keyraphi/esp8266_infrasound/(commit log)

2024-06-28 Started on wifi setting page. Submit button is not working yet
2024-07-03 Use arduino ide to code the esp8266
2024-07-07 Fixed missing minimum buffer size
    [infrasound_esp.ino.cpp]
2024-07-14 Bug fix ... data file was not opened.
    [arduino_infrasound_sensor.ino.cpp, esp8266_infrasound_webserver.ino.cpp]
2024-07-14 Send initial sensor data request asynchronously
2024-09-22 Use a D1 mini for the sensor
2024-09-25 Keep track of measurement index.
2024-10-10 Integrated Spectrogram to actual measurements and simple bug fixes
    [esp8266_infrasound_webserver.ino.cpp]
2024-10-20 Switch ui elements on and off
2024-10-22 Replaced wifi setup with setup via usb
    [esp8266_infrasound_webserver.ino.cpp]
2024-10-25 Update README.md with Windows driver
2026-08-06 Add tested protocol, file format and status modules
    Introduces the pure logic layer shared by both boards, together with a native test harness so it can be exercised on a PC rather than only on hardware.
    infrasound_frame.h defines the 11-byte link packet (start marker, float value, uint32 sensor timestamp, CRC-8, end marker) and a decoder that resynchronises one byte at a time. The previous parser discarded a whole packet width on a bad end marker, which could swallow a valid packet that began inside it, and had no checksum, so a corrupted packet could be accepted as a plausible measurement.
    measurement_file.h defines a 32-byte header and 8-byte records, with the record count derived from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
2026-08-06 Sensor: timestamp in the ISR, CRC packets at 38400 baud
    The sampling interrupt now records millis() alongside setting its flag, so each measurement carries the instant it was intended to be taken rather than whenever loop() got round to reading the sensor. A missed tick therefore shows up as a 40 ms gap in the data instead of silently compressing the time axis.
    The interrupt flag and its timestamp are now snapshotted together before the I2C read. Previously the flag was cleared after the read, so a tick firing during the transaction was silently swallowed.
    The timer handler gains IRAM_ATTR, which ESP8266TimerInterrupt requires; without it the handler can fault when the interrupt fires whil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
    [arduino_infrasound_sensor.ino.cpp]
2026-08-06 Service: add held-open SD logger with rotation and a run counter
    Replaces a writer that opened, wrote and closed the measurement file on every flush, and that silently discarded up to 252 buffered samples whenever a write failed.
    The file is now held open for the life of a part. Records are buffered in 512-byte units matching SdFat's cache block, and sync() runs on its own 10-second timer rather than after every write, because sync() is what touches the directory entry and the FAT and so carries the variable latency.
    A failed write no longer resets the buffer counter: it records the failure, stops logging and closes the handle so the directory entry reflects what actually reached the card.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
    [logger.cpp, logger.h]
2026-08-06 Service: copy web assets from the SD card into flash at boot
    The web interface was served straight from the SD card, reopening and reseeking the file for every chunk of every request. Those reads happen in the network callback context and stall the main loop, which is where measurements are lost.
    The assets are now copied into the internal flash filesystem once at boot. Detection reads only directory entries, comparing each file's size and modification time against a manifest, so an unchanged restart costs a directory scan rather than re-reading the whole tree. A checksum is computed from the bytes already passing through during a copy, so verification is free.
    Each file is written to a te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
    [static_sync.cpp, static_sync.h]
2026-08-06 Service: rework the receive path, endpoints and status reporting
    This is the sketch-side half of the rework and the part that addresses the measurement loss directly.
    Receive path: the software-serial buffers are sized explicitly (256-byte byte buffer, 2048-entry interrupt buffer) instead of relying on library defaults that tolerated only about 128 ms of stalled loop() before dropping bytes silently. Buffer overflow is now read and counted. The two parallel queues, kept in step by hand, become one queue of timestamped samples. The drain loop no longer re-evaluates a bound that shrinks as it pops, which previously drained only half the queue per pass, and a rejected byte no longer aborts the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
    [esp8266_infrasound_webserver.ino.cpp]
2026-08-06 Web interface: read the new record format and batched live stream
    measurement_parsing.js holds the parsing shared by both pages, kept free of DOM access so it can be unit tested under Node. It covers the batched live messages, the file header, the new 8-byte records and the previous bare-float format.
    The live view reconstructs sample times from the sensor's own timestamps instead of from a running index, so a dropped sample appears as a gap rather than silently shifting everything after it.
    The analysis page fetches the binary endpoint, routes older recordings to the legacy reader, and draws a break where the timestamps show a discontinuity instead of interpolating across it. The gap thre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
2026-08-06 Dokumentation der neuen Dateiformate, Verbindung und LED-Anzeige
    Beschreibt die neue Aufteilung des Flash-Speichers, dass der static-Ordner weiterhin auf die SD-Karte kommt und beim Start ins Flash kopiert wird, sowie die Warnung, dass beide Platinen zusammen neu programmiert werden muessen.
    Ergaenzt die Begruendungen zu den drei technischen Entscheidungen: warum die Verbindung mit 38400 Baud laeuft und bewusst nicht schneller, warum jeder Messwert jetzt einen eigenen Zeitstempel traegt und damit 8 statt 4 Byte belegt, und warum alle Zeilen der CSV-Datei gleich lang sind.
    Dokumentiert ausserdem die Muster der Status-LED, den Aufbau der Messdateien, die Dateibenennung mit Lauf- und Teilnumm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
2026-08-06 Fix missing csv_format.h include and warn about updating the SD card
    The service sketch used CSV_HEADER_LEN, CSV_LINE_LEN and csvHeader() without including csv_format.h, so it did not compile.
    Also documents a trap found while flashing: updating the firmware without re-copying the static folder to the SD card leaves new firmware serving the old web page. Because /downloads now returns objects rather than bare filenames, an old page renders [object Object] in the measurement list and asks the server for a file by that name, which it correctly rejects. The old page also loads Bootstrap and Highcharts from the internet, so the layout breaks on a network without internet access.
    [esp8266_infrasound_webserver.ino.cpp]
2026-08-06 feat(service): support multiple WiFi SSIDs with priority fallback
    wifi_ssid_pw.txt now holds one "SSID password" line per network, in
    priority order (last space splits SSID from password, so SSIDs may
    contain spaces). A new pure parser (wifi_credentials.h, natively
    tested) handles this plus the old two-line single-network format for
    backward compatibility.
    initWifi() now scans once, tries only the configured SSIDs the scan
    actually saw, and passes an explicit 15s timeout to
    waitForConnectResult() instead of relying on its 60s default - so a
    list of networks doesn't become expensive to walk. write_wifi_credentials()
    appends instead of overwriting, so adding a network on site no longer
    discar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
    [esp8266_infrasound_webserver.ino.cpp, wifi_credentials.h]
2026-08-06 fix: open sensor serial link last; share link baud rate
    esp_serial.begin() ran before initTimestamp()/initWebserver() in setup(),
    leaving the receive buffer open and undrained for several seconds while NTP
    and the webserver came up. That overflowed the buffer at boot, corrupting a
    frame the decoder then seeded from -- the "ovf=1 crc=N frm=50" pinned in the
    first minute of DIAG output on real hardware. Move the esp_serial.begin
    block (with its validity check and log lines) to the very end of setup(), so
    the link opens immediately before loop() starts draining it.
    Also move the link's 38400 baud rate, previously hardcoded separately in
    both sketches, into infrasound::LINK_BAUD in the shared p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
    [arduino_infrasound_sensor.ino.cpp, esp8266_infrasound_webserver.ino.cpp, infrasound_frame.h]
2026-08-06 docs(readme): document the DIAG diagnostics line
    Add a section explaining the once-a-minute DIAG line the webserver
    writes to its USB console, placed next to the Status-LED section
    since they are the device's two diagnostics.
2026-08-06 feat(led): add NoData and Stopped states
    A dead sensor board and a deliberately stopped measurement both used
    to look identical to healthy Ok on the status LED, since the
    measurement flag and open log file give no signal either way. NoData
    (triple flash) fires when is_measurement_running but no frame has been
    accepted for LED_NO_DATA_MS; Stopped (1s on/1s off) fires when the
    measurement was stopped deliberately. Both gate correctly against the
    "deliberate stop looks like a fault" trap the double-blink already had
    to be fixed for once.
    [esp8266_infrasound_webserver.ino.cpp, led_status.h]
